Nervado/tcc-antenas-microfita-fractal/apresentacao/Antenas de Microfita com Patch Fractal.pptx

## Antenas de Microfita com Patch Fractal

Trabalho de Conclusão de Curso
Evandro Abreu de Oliveira

## Sumário

- Contextualização.
- Objetivos do trabalho.
- Fundamentação teórica.
- Fractais e Antenas de Microfita.
- Metodologia proposta.
- Projeto das estruturas.
- Simulação.
- Avaliação dos resultados.
- Considerações finais.
- Referências.

## Contextualização

## Objetivos do trabalho

## Fundamentação teórica

## Fractais e Antenas de Microfita

## Metodologia proposta

## Projeto das estruturas

## Simulação

## Avaliação dos resultados

## Considerações finais

## Referências

[1]BALANIS, C. A. Antenna Theory: Analysis and Design. 3. ed. New Jersey,USA: John
Wiley & Sons, Inc., 2005.
[2]BDRORE, J. S. A wire model for the sierpinski gasket type monopole antenna and a
truly broadband bent-wire antenna. Student Conference on Research and Development
(SCOReD 2006), Ottawa, Canada, p. 20{24, 10 Jul. 2004.
[3]ELKAMCHOUCHI, H. M.; ABOUELSEOUD, G. A compact broadband sierfwinski
gasket patch microstrip antenna. National Radio Science Conference (NRSC2004),
Cairo, Egito, p. 110{114, 16 mar. 2004.
[4]HAMZAH, S. A. et al. Design, simulation, fabrication and measurement of a 900mhz
koch fractal dipole antenna. Student Conference on Research and Development (SCOReD
2006), Shah Alam, Selangor, MALAYSIA, p. 120{123, 27-28 June 2006.
[5]JAMIL, A.; YUSOFF, M. Z.; YAHYA, N. Small koch fractal antennas for wireless local
area network. Universiti Teknologi PETRONAS, Perak, MALAYSIA, 2006.
[6]KOUNTOURIOTIS, J. et al. Recongurable antennas for mimo ad-hoc networks. 2008
IEEE Radio and Wireless Symposium, FLorida, EUA, p. 563 { 566, Janeiro 2008.
[7]MRABET, O. E. HFSS Tutorial. [S.l.], 2011. Disponvel em: <http://www.scribd.com>.
Acesso em: 8 mar. 2011.
[8]NA, Y.; XIAO-WEI, S. Analysis of the multiband behavior on sierpinski carpet fractal
antennas. APMC2005 Proceedings, Shaanxi, China, p. 70{74, 30 abr. 2005.
[9]OLIVEIRA, E. E. C. de. Antenas de microta com patch quase fractal para aplicac~oes
em redes wpan/wlan. Dissertac~ao de Mestrado, Natal,Brasil, 2009.
