Nervado/tcc-antenas-microfita-fractal/tcc/arquivos_para_alterar/a02-configurar.tex

%Colocar "true" para os elementos que devem aparecer
%Colocar "false" para os elementos que não devem aparecer

%Troque por true/false para inserir/não inserir: Capa
\setboolean{InserirCapa}{true}

%Troque por true/false para inserir/não inserir: Folha de Rosto (Elemento OBRIGATÓRIO)
\setboolean{InserirFolhaRosto}{true}

%Troque por true/false para inserir/não inserir: Folha de Aprovação (Elemento OBRIGATÓRIO)
\setboolean{InserirFolhaAprovacao}{false}

%Troque por true/false para inserir/não inserir: Dedicatória (Elemento OPCIONAL)
\setboolean{InserirDedicatoria}{false}

%Troque por true/false para inserir/não inserir: Agradecimentos (Elemento OPCIONAL)
\setboolean{InserirAgradecimentos}{false}

%Troque por true/false para inserir/não inserir: Epígrafe (Elemento OPCIONAL)
\setboolean{InserirEpigrafe}{false}

%Troque por true/false para inserir/não inserir: Resumo (Elemento OBRIGATÓRIO)
\setboolean{InserirResumo}{true}

%Troque por true/false para inserir/não inserir: Abstract (Dissertação/Tese: Elemento OBRIGATÓRIO; TCC:Elemento OPCIONAL)
\setboolean{InserirAbstract}{false}

%Troque por true/false para inserir/não inserir: Sumário (Elemento OBRIGATÓRIO)
\setboolean{InserirSumario}{true}

%Troque por true/false para inserir/não inserir: Lista de Ilustrações (Elemento OPCIONAL; Mais de 5 figuras no trabalho: Elemento OBRIGATÓRIO)
\setboolean{InserirListaIlustracoes}{true}

%Troque por true/false para inserir/não inserir: Introdução (Elemento OBRIGATÓRIO)
\setboolean{InserirIntroducao}{true}

%Troque por true/false para inserir/não inserir: Desenvolvimento (Elemento OBRIGATÓRIO)
\setboolean{InserirDesenvolvimento}{true}

%Troque por true/false para inserir/não inserir: Conclusão (Elemento OBRIGATÓRIO)
\setboolean{InserirConclusao}{true}

%Troque por true/false para inserir/não inserir: Referências Bibliográficas (Elemento OBRIGATÓRIO)
\setboolean{InserirReferencias}{true}

%Troque por true/false para inserir/não inserir: Apêndice (Elemento OPCIONAL)
\setboolean{InserirApendice}{false}

%Troque por true/false para inserir/não inserir: Anexo (Elemento OPCIONAL)
\setboolean{InserirAnexo}{false}

%%%%%%%%%%%%%%%%%%%%%%%%%%%%%%%%%%%%%%%%%%%%%%%%%%%%%
% Modelo para escrever TCCs,dissertações e teses utilizando LaTeX, ABNTeX e BibTeX
% Autor/E-Mail: Robinson Alves Lemos/contato@robinson.mat.br/robinson.a.l@bol.com.br
% Data: 19/04/2008 
% Colaboradore(s)/E-Mail(s):
% Caso queira colaborar, entre em contato pelo e-mail e informe alterações que realizou.
%%%%%%%%%%%%%%%%%%%%%%%%%%%%%%%%%%%%%%%%%%%%%%%%%%%%%
