Nervado/tcc-antenas-microfita-fractal/tcc/arquivos_para_alterar/a07-resumo.tex

%Digite seu resumo aqui.
O presente trabalho consiste em uma atividade acadêmica obrigatória para integralização curricular do curso de Engenharia Elétrica da Universidade Federal do Rio Grande do Norte. As atividades relativas a seu desenvolvimento foram realizadas durante
a vigência do projeto de pesquisa "Antenas de Microfita com Patch Fractal para Aplicações em Sistemas de Comunicações Sem Fio", sob o apoio financeiro do CNPQ.

O estudo de miniaturização de antenas de microfita surge como alternativa para uma gama imensa de aplicações, desde empreendimentos militares, equipamentos médicos, radares ou comunicações sem fio. O interesse sobre estas estruturas está ligado a sua versatilidade e maleabilidade, ao baixo custo de fabricação e a simplicidade de projeto. É bastante comum na literatura novas publicações com novas abordagens para projetos de antenas de microfita com patchs, substrato e plano de terra modificados, como em \cite{ref2}, \cite{ref5} e \cite{ref6} .

Este trabalho de conclusão consiste no projeto de antenas com contornos fractais com o objetivo de demonstrar a viabilidade de sua aplicação na miniaturização de antenas de microfita. Os conceitos básicos sobre antenas serão discutidos com o propósito de demonstrar o embasamento teórico necessário para a compreensão do assunto.
O conceito de curva fractal será também abordado neste texto com vistas à fundamentação do tema em paralelo com sua aplicabilidade à proposta do trabalho.

Será explorada a técnica de modelamento como linha de transmissão, a utilização de softwares para cálculo de dimensões, desenho e análise das estruturas propostas. Ao final do trabalho será apresentada a avaliação dos resultados alcançados com a aplicação da curva de Koch à uma antena de microfita com patch retangular com dois níveis de iteração, os quais demostram a eficiência da técnica de miniaturização empregada.

\begin{quote}
%Texto a ser indentado.

\textbf{Palavras-chave}: Antenas de Microfita, Fractais e Miniaturização de Antenas.

\end{quote}
%%%%%%%%%%%%%%%%%%%%%%%%%%%%%%%%%%%%%%%%%%%%%%%%%%%%%
% Modelo para escrever TCCs, dissertações e teses utilizando LaTeX, ABNTeX e BibTeX
% Autor/E-Mail: Robinson Alves Lemos/contato@robinson.mat.br/robinson.a.l@bol.com.br
% Data: 19/04/2008 
% Colaboradore(s)/E-Mail(s):
% Caso queira colaborar, entre em contato pelo e-mail e informe alterações que realizou.
%%%%%%%%%%%%%%%%%%%%%%%%%%%%%%%%%%%%%%%%%%%%%%%%%%%%%
