Nervado/tcc-antenas-microfita-fractal/tcc/arquivos_para_alterar/a09-introducao.tex

O constante avanço da tecnologia, sobretudo nas áreas de microeletrônica e comunicações vem provocando uma revolução mundial no acesso a dispositivos eletrônicos portáteis como: Celulares, PDA's, Notebooks, Smartphones e etc. A grande quantidade de usuários destes aparelhos busca sempre novos e cada vez mais rápidos serviços como internet, videoconferência, chats, jogos e vídeos.

Para implementar tantas aplicações e ainda possuírem design atrativo, os dispositivos, que são compatíveis com as redes 3G e 4G, devem possuir inúmeros circuitos integrados, baixo consumo de potência e pequeno tamanho. Neste contexto, as antenas dos novos "Gadgets" devem ocupar pouco espaço e ainda serem altamente eficientes. As técnicas de miniaturização de antenas surgem como oportunidade para o desenvolvimento de estruturas radiantes menores e com baixo consumo de energia.

O trabalho em si tem como objetivo explorar o conceito de miniaturização de antenas de microfita com patch semi-fractal para aplicações em sistemas de comunicação sem fio. Será apresentando o método utilizado para a obtenção de antenas miniaturizadas por curvas fractais e o método matemático para a obtenção das dimensões da estrutura base que foi escolhido como sendo o método da linha de transmissão.

O conceito de fractal será objetivamente explorado no trabalho com vistas ao entendimento básico acerca de suas propriedades, do método de construção e da sua aplicabilidade no contexto das antenas planares.
Serão demonstrados os procedimentos de simulação e avaliação 
do desempenho das estruturas propostas e extraídas conclusões a partir dos resultados alcançados.

%%%%%%%%%%%%%%%%%%%%%%%%%%%%%%%%%%%%%%%%%%%%%%%%%%%%%
% Modelo para escrever TCCs, dissertações e teses utilizando LaTeX, ABNTeX e BibTeX
% Autor/E-Mail: Robinson Alves Lemos/contato@robinson.mat.br/robinson.a.l@bol.com.br
% Data: 19/04/2008 
% Colaboradore(s)/E-Mail(s):
% Caso queira colaborar, entre em contato pelo e-mail e informe alterações que realizou.
%%%%%%%%%%%%%%%%%%%%%%%%%%%%%%%%%%%%%%%%%%%%%%%%%%%%%
