Nervado/tcc-antenas-microfita-fractal/tcc/arquivos_para_alterar/a11-conclusao.tex

O trabalho realizado cumpriu com o proposto de demonstrar a aplicação de uma curva fractal na miniaturização de uma antena de microfita com patch retangular. Os resultados alcançados estão de acordo com o observado na literatura do assunto \cite{ref4}.

Destaca-se a relevância do desempenho das antenas projetadas como satisfatório em contraste com a utilização de um método
não preciso de projeto empregado, no caso o modelo da linha de transmissão.

Demonstrou-se ao longo do presente texto, os conhecimento adquiridos ao longo da graduação de Engenharia Elétrica, sobretudo, no que concerne a área de Telecomunicações mais especificadamente à área de Propagação e Antenas que foram utilizados para compreensão geral do assunto e a para a devida execução do desenvolvimento do trabalho.

Para trabalhos futuros sugere-se a aplicação de outros contornos fractais e a construção das estruturas para medições experimentais \textit{indoor}.

Por fim, destaca-se também a relevância do desenvolvimento do trabalho de conclusão de curso como instrumento de aprimoramento
do aluno de Engenharia Elétrica e como medida de sua capacidade de aplicação do conteúdo estudado durante a participação no projeto de iniciação científica da UFRN/CNPQ.

%%%%%%%%%%%%%%%%%%%%%%%%%%%%%%%%%%%%%%%%%%%%%%%%%%%%%
% Modelo para escrever TCCs, dissertações e teses utilizando LaTeX, ABNTeX e BibTeX
% Autor/E-Mail: Robinson Alves Lemos/contato@robinson.mat.br/robinson.a.l@bol.com.br
% Data: 19/04/2008 
% Colaboradore(s)/E-Mail(s):
% Caso queira colaborar, entre em contato pelo e-mail e informe alterações que realizou.
%%%%%%%%%%%%%%%%%%%%%%%%%%%%%%%%%%%%%%%%%%%%%%%%%%%%%
