Nervado/tcc-antenas-microfita-fractal/tcc/arquivos_para_alterar/a12-referenciasnaocidadas.tex

%\nocite{ref2}
\nocite{ref3}
\nocite{ref4}
%\nocite{ref5}
%\nocite{ref6}
%\nocite{ref7}
\nocite{ref8}
\nocite{ref9}
\nocite{ref10}
\nocite{ref11}

%inclua um \nocite{Nome da Referência} para cada referência que não foi citada no texto e você deseja que apareça nas Referências.

%%%%%%%%%%%%%%%%%%%%%%%%%%%%%%%%%%%%%%%%%%%%%%%%%%%%%
% Modelo para escrever TCCs, dissertações e teses utilizando LaTeX, ABNTeX e BibTeX
% Autor/E-Mail: Robinson Alves Lemos/contato@robinson.mat.br/robinson.a.l@bol.com.br
% Data: 19/04/2008 
% Colaboradore(s)/E-Mail(s):
% Caso queira colaborar, entre em contato pelo e-mail e informe alterações que realizou.
%%%%%%%%%%%%%%%%%%%%%%%%%%%%%%%%%%%%%%%%%%%%%%%%%%%%%

%minha referencia
