Nervado/tcc-antenas-microfita-fractal/tcc/figuras/prototipos.png

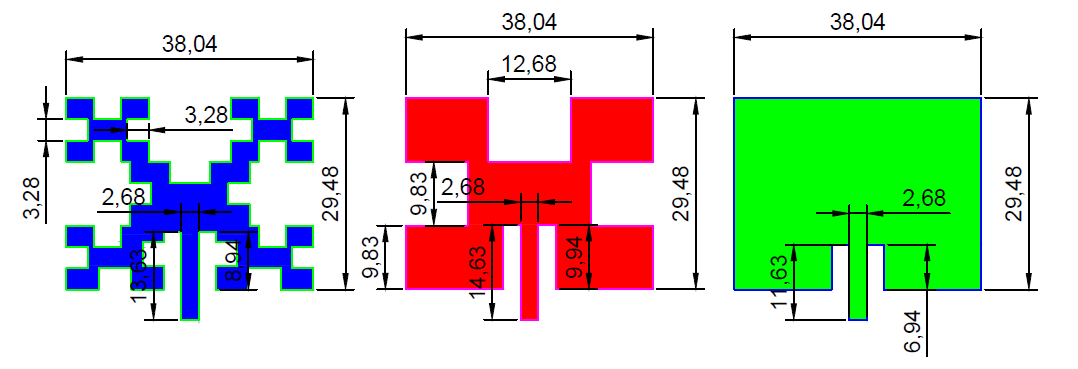
tcc/figuras/prototipos.png
