Nervado/tcc-antenas-microfita-fractal/prototipos/Desenho2.dxf

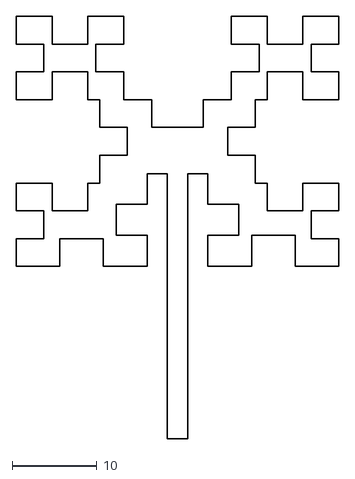
[picture p29: CAD file, 2026-10-20]
prototipos/Desenho2.dxf
38.0 x 49.8
