Nervado/tcc-antenas-microfita-fractal/prototipos/Desenho1.dxf

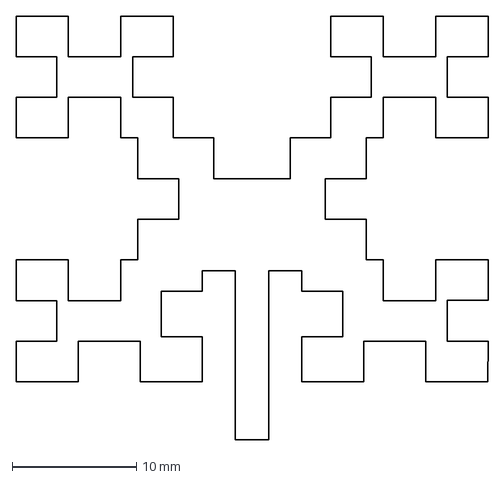
[picture p30: CAD file, 2026-10-20]
prototipos/Desenho1.dxf
38.0 x 34.2 mm
