Nervado/tcc-antenas-microfita-fractal/prototipos/versaonova.dxf

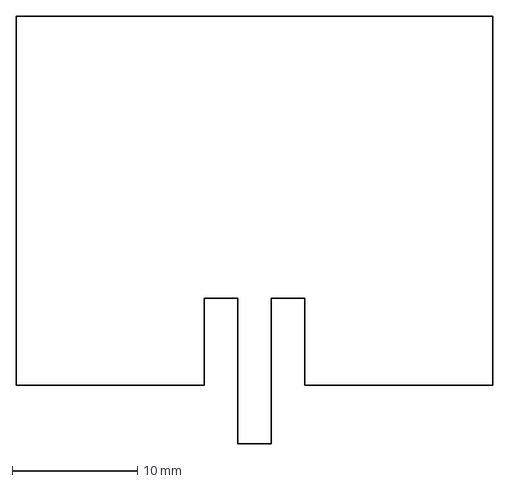
[picture p31: CAD file, 2026-10-20]
prototipos/versaonova.dxf
38.0 x 34.2 mm
