Nervado/tcc-antenas-microfita-fractal/prototipos/versao2.dxf

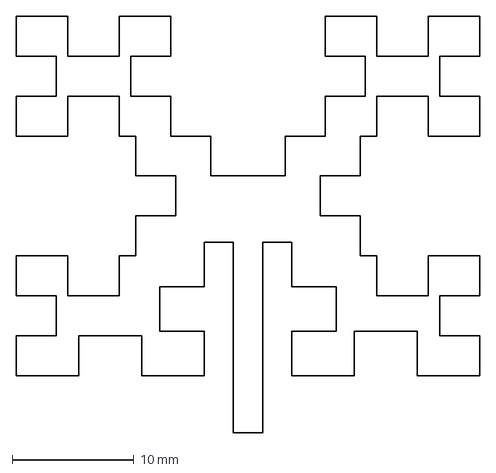
[picture p32: CAD file, 2026-10-20]
prototipos/versao2.dxf
38.0 x 34.2 mm
