Nervado/tcc-antenas-microfita-fractal/prototipos/versao1.1.dxf

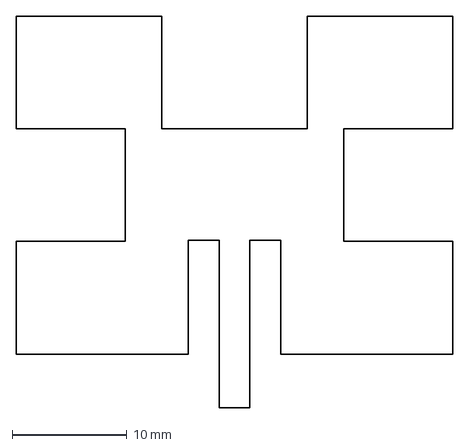
[picture p33: CAD file, 2026-10-20]
prototipos/versao1.1.dxf
38.0 x 34.2 mm
