Nervado/tcc-antenas-microfita-fractal/prototipos/Desenho3.dxf

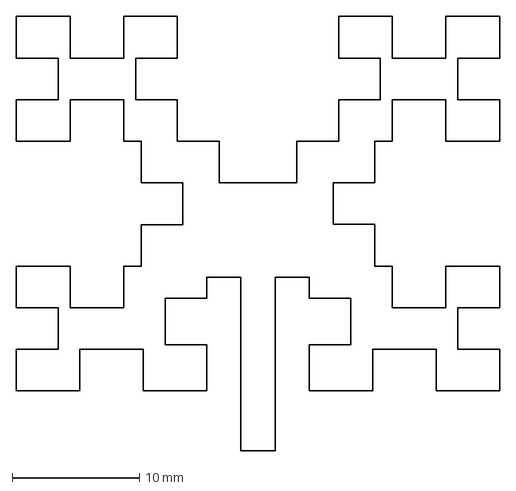
[picture p34: CAD file, 2026-10-20]
prototipos/Desenho3.dxf
38.0 x 34.2 mm
