Nervado/tcc-antenas-microfita-fractal/(list of files, cad)

Other CAD files:
prototipos/antenas2.dwg
prototipos/antenas.dwg
prototipos/Desenho1.dwg
prototipos/Desenho2.dwg
prototipos/versaonova.dwg
