Nervado/tcc-antenas-microfita-fractal/tcc/figuras/teste.jpg

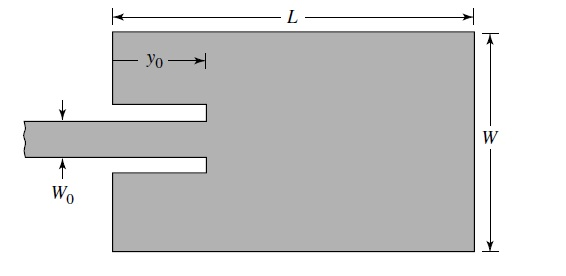
tcc/figuras/teste.jpg
