Nervado/tcc-antenas-microfita-fractal/prototipos/antenas2.pdf

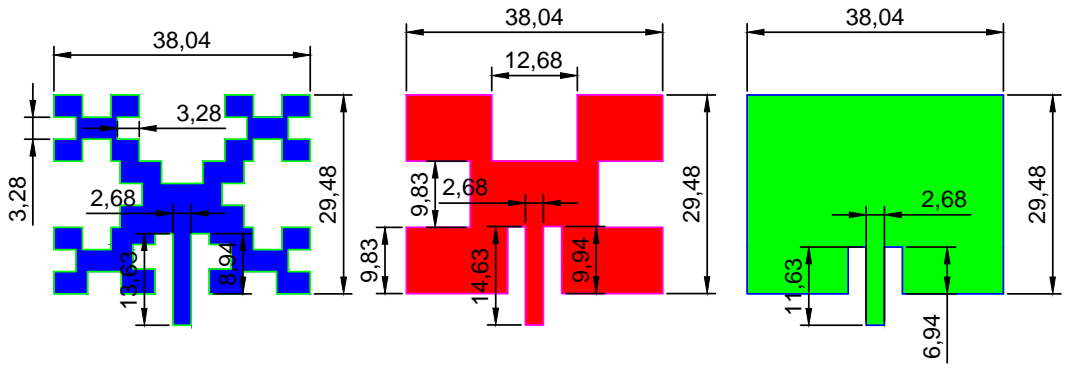
[picture p36: page 1]
