Nervado/tcc-antenas-microfita-fractal/prototipos/Antenas_Final.pdf

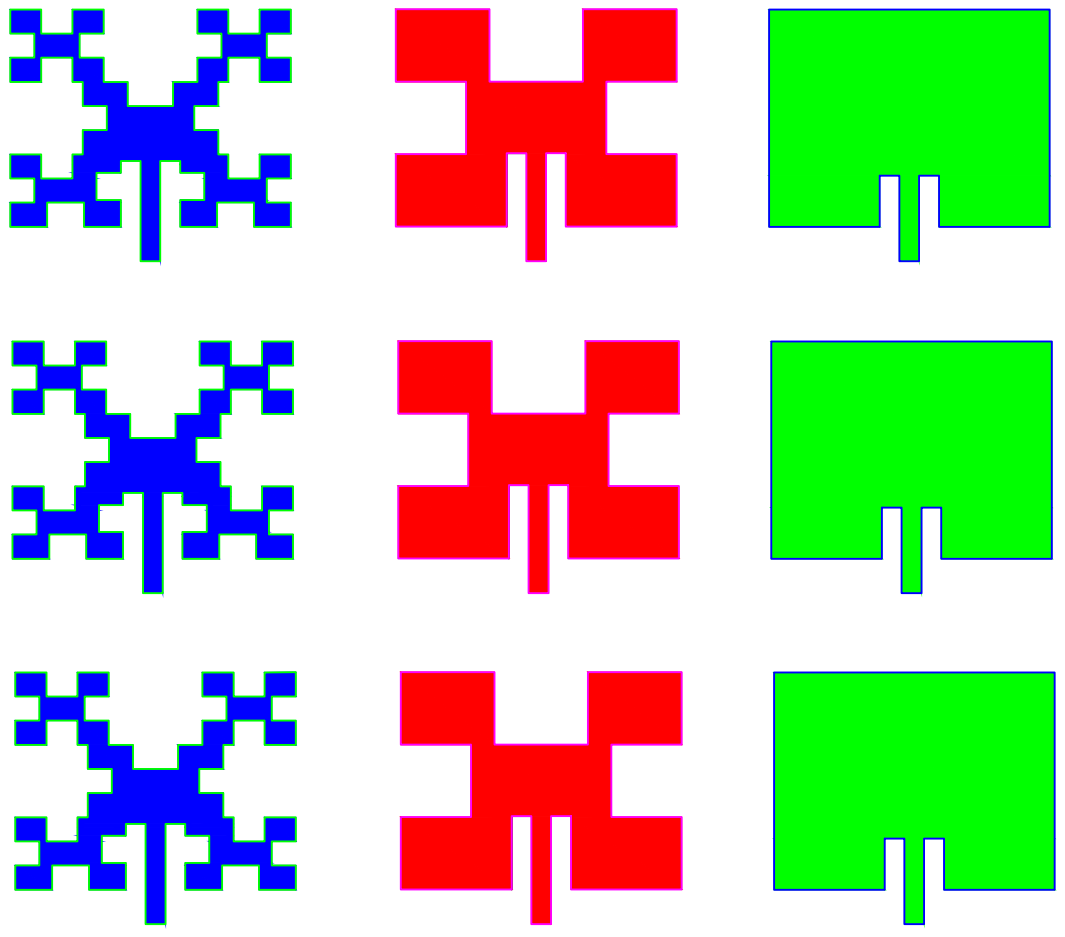
[picture p37: page 1]
