Nervado/tcc-antenas-microfita-fractal/(commit log)

2026-10-20 docs(tcc): arquiva TCC de antenas de microfita com patch fractal (UFRN, 2011)
    Preserva publicamente, como registro histórico, o material original recuperado do
    backup antigo: fonte LaTeX e PDF final, slides, relatórios de IC, cálculo em C e
    desenhos dos protótipos. Material de terceiros (artigos, livros, dissertações) excluído.
    Claude-Session: https://claude.ai/code/session_01WWKZcPd7F1ePfVLQVhSWGT
2026-10-20 docs(readme): adiciona notas de revisão (2026) ao TCC
    Registra três correções conceituais (perda de retorno vs ganho, HFSS usa FEM,
    área escala com 1/f²) sem alterar o texto original de 2011.
    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
